acrobotic/IK_Breakout_ATxmega32E5/pcb/fab/BOM.xls

IK Dragonfly – BOM
Cisco Zabala (x1sc0@acrobotic.com) last updated: 05.09.2014
Manufacturer | Manuf. Part Number | Vendor | Vendor Part Number | Type | Designator | Qty | Description | Case | SMD, BGA, LCC, OR TH | Notes
Rohm | MCR03ERTJ220 | Digi-Key | RHM22CGCT-ND | Resistors | R1, R2 | 2 | RES 22 OHM 1/10W 5% 0603 SMD | 0603 | SMD
Stackpole Electronics Inc | RMCF0603JT10K0 | Digi-Key | RMCF0603JT10K0CT-ND |  | R3 | 1 | RES 10K OHM 1/10W 5% 0603 | 0603 | SMD
Stackpole Electronics Inc | RMCF0603JT10K0 | Digi-Key | RMCF0603JT10K0CT-ND |  | R4 | 1 | RES 300 OHM 1/10W 5% 0603 | 0603 | SMD
Stackpole Electronics Inc | RMCF0603JT1K00 | Digi-Key | RMCF0603JT1K00CT-ND |  | R5, R6 | 2 | RES 1K OHM 1/10W 5% 0603 | 0603 | SMD
Yageo | CC0603ZRY5V9BB104 | Digi-Key | 311-1343-1-ND | Capacitors | C1, C2, C5, C6, C7 | 5 | CAP CER 0.1UF 50V Y5V 0603 | 0603 | SMD
Kemet | T491A106K010AT7280 | Digi-Key | 399-8268-1-ND |  | C3 | 1 | CAP TANT 10UF 10V 10% 1206 | 1206 | SMD
Murata | GRM188F51A475ZE20D | Digi-Key | 490-3302-1-ND |  | C4, C8 | 2 | CAP CER 4.7UF 10V Y5V 0603 | 0603 | SMD
Samsung | CIB10P330NC | Digi-Key | 1276-6387-1-ND | Inductors | L1, L2 | 2 | FERRITE CHIP 33 OHM 1000MA | 0603 | SMD
OSRAM | LB Q39E-N1P1-35-1 | Digi-Key | 475-2815-1-ND | LEDs | ON | 1 | LED CHIPLED BLUE 470NM 0603 SMD | 0603 | SMD
OSRAM | LY Q976-P1S2-36 | Digi-Key | 475-2558-1-ND | IC | L | 1 | LED CHIPLED 587NM YLW 0603 SMD | 0603 | SMD
Atmel | ATXMEGA32E5-AU | Mouser | 556-ATXMEGA32E5-AU | ICs | IC1 | 1 | IC MCU 8BIT 32KB FLASH 32TQFP | 32TQFP | SMD
FTDI | FT230XS-R | Mouser | 895-FT230XS-R |  | IC2 | 1 | IC USB SERIAL BASIC UART | 16SSOP | SMD
Micrel | MIC5219-3.3YM5 | Mouser | 998-MIC5219-3.3YM5TR |  | U1 | 1 | IC REG LDO 3.3V 0.5A | SOT23-5 | SMD
STM | LM4040D20IDBZR | Mouser | 595-LM4040D20IDBZR |  | U2 | 1 | IC VREF SHUNT 2.048V | SOT23-3 | SMD
Bourns Inc. | MF-FSMF050X-2 | Mouser | 652-MFFSMF050X-2 | Fuses | FUSE | 1 | FUSE PTC RESET 500MA SMD 0603 | 0603 | SMD
 |  | Acrobotic |  | Buttons | RESET | 1 | Momentary Tactile Push Button | 3mm x 3.5mm | SMD
 |  | Acrobotic | CON-00009 | Connectors | JP1, JP2, JP3, JP4 | 1 | 0.1” Pitch, 40-Pin (Male) |  | TH | Easily cut to length. Left open for user
 |  | Acrobotic | CON-00010 |  | J1 | 1 | Break-away Pin Connector, 0.1" Pitch, 2x3-Pin (Male, TH, used for ISP) |  | TH
 |  | Acrobotic | CON-00014 |  | USB | 1 | USB Micro-B Connector (Through Hole) |  | TH
