acrobotic/IK_Breakout_ATxmega32E5/pcb/ik_dragonfly.pdf

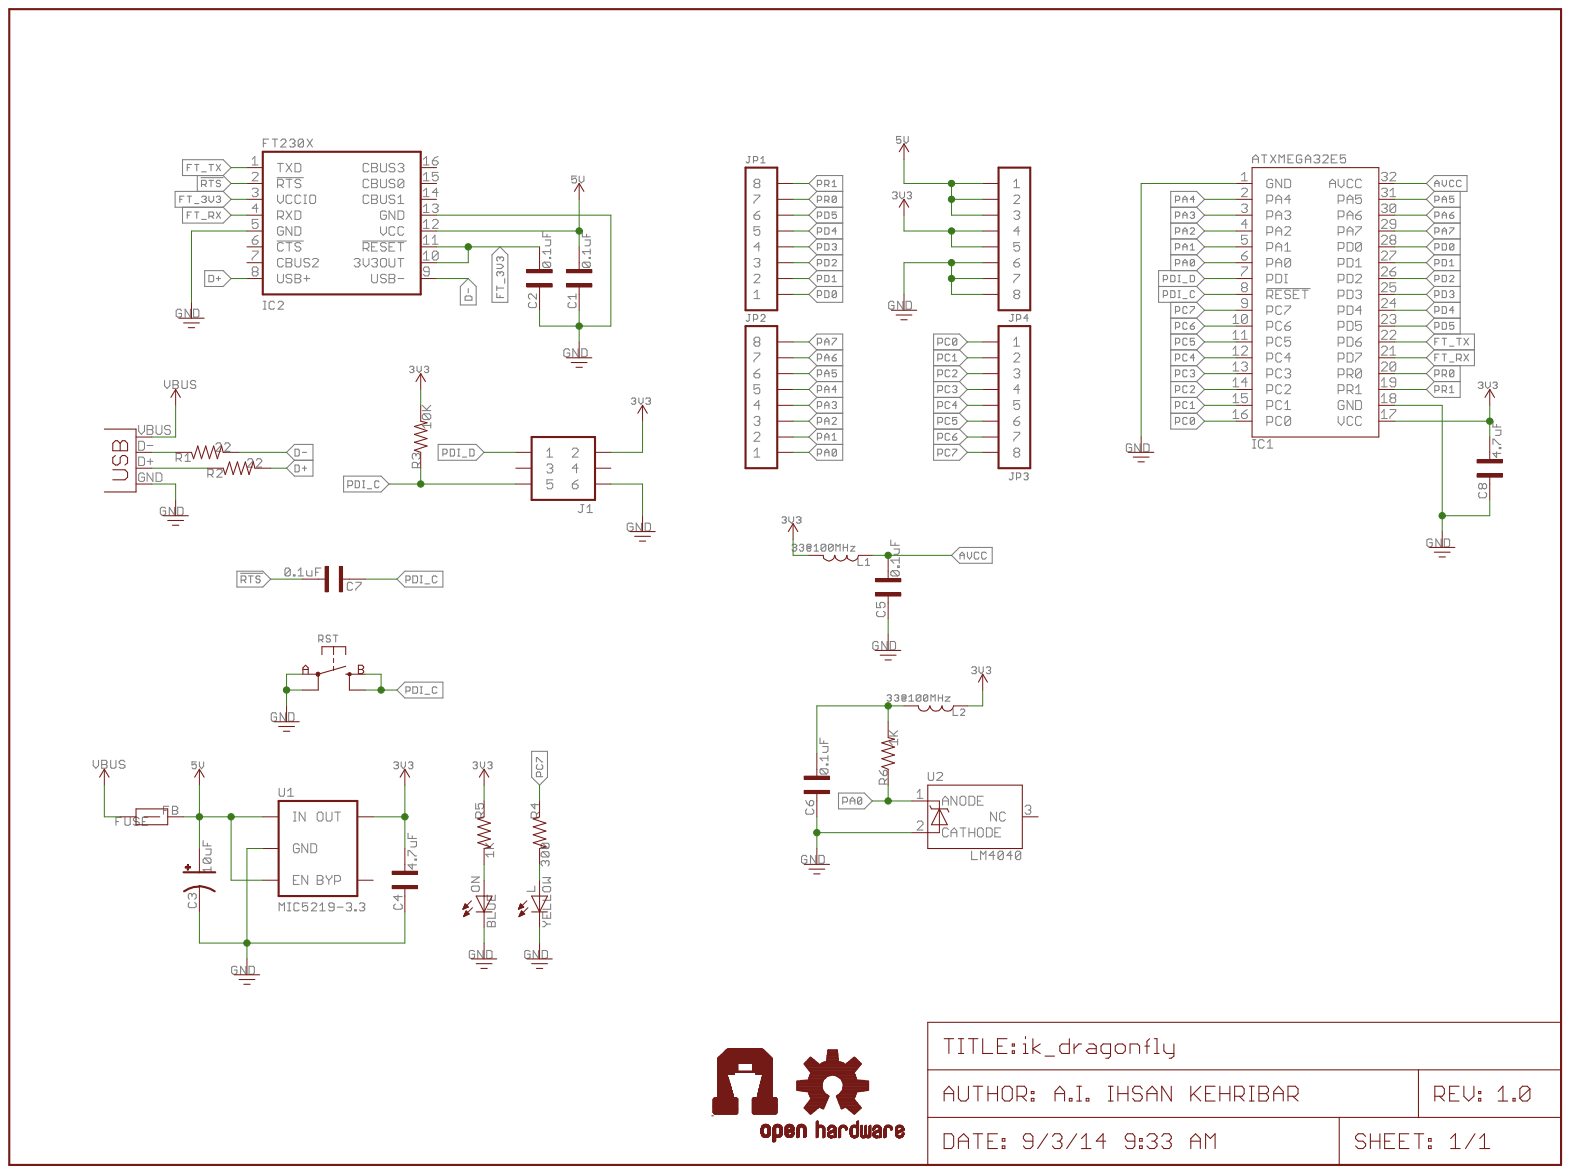
[picture p1: page 1]
