acrobotic/IK_Breakout_ATxmega32E5/pcb/ik_dragonfly.brd

## EAGLE design pcb/ik_dragonfly.brd (2014-08-26)

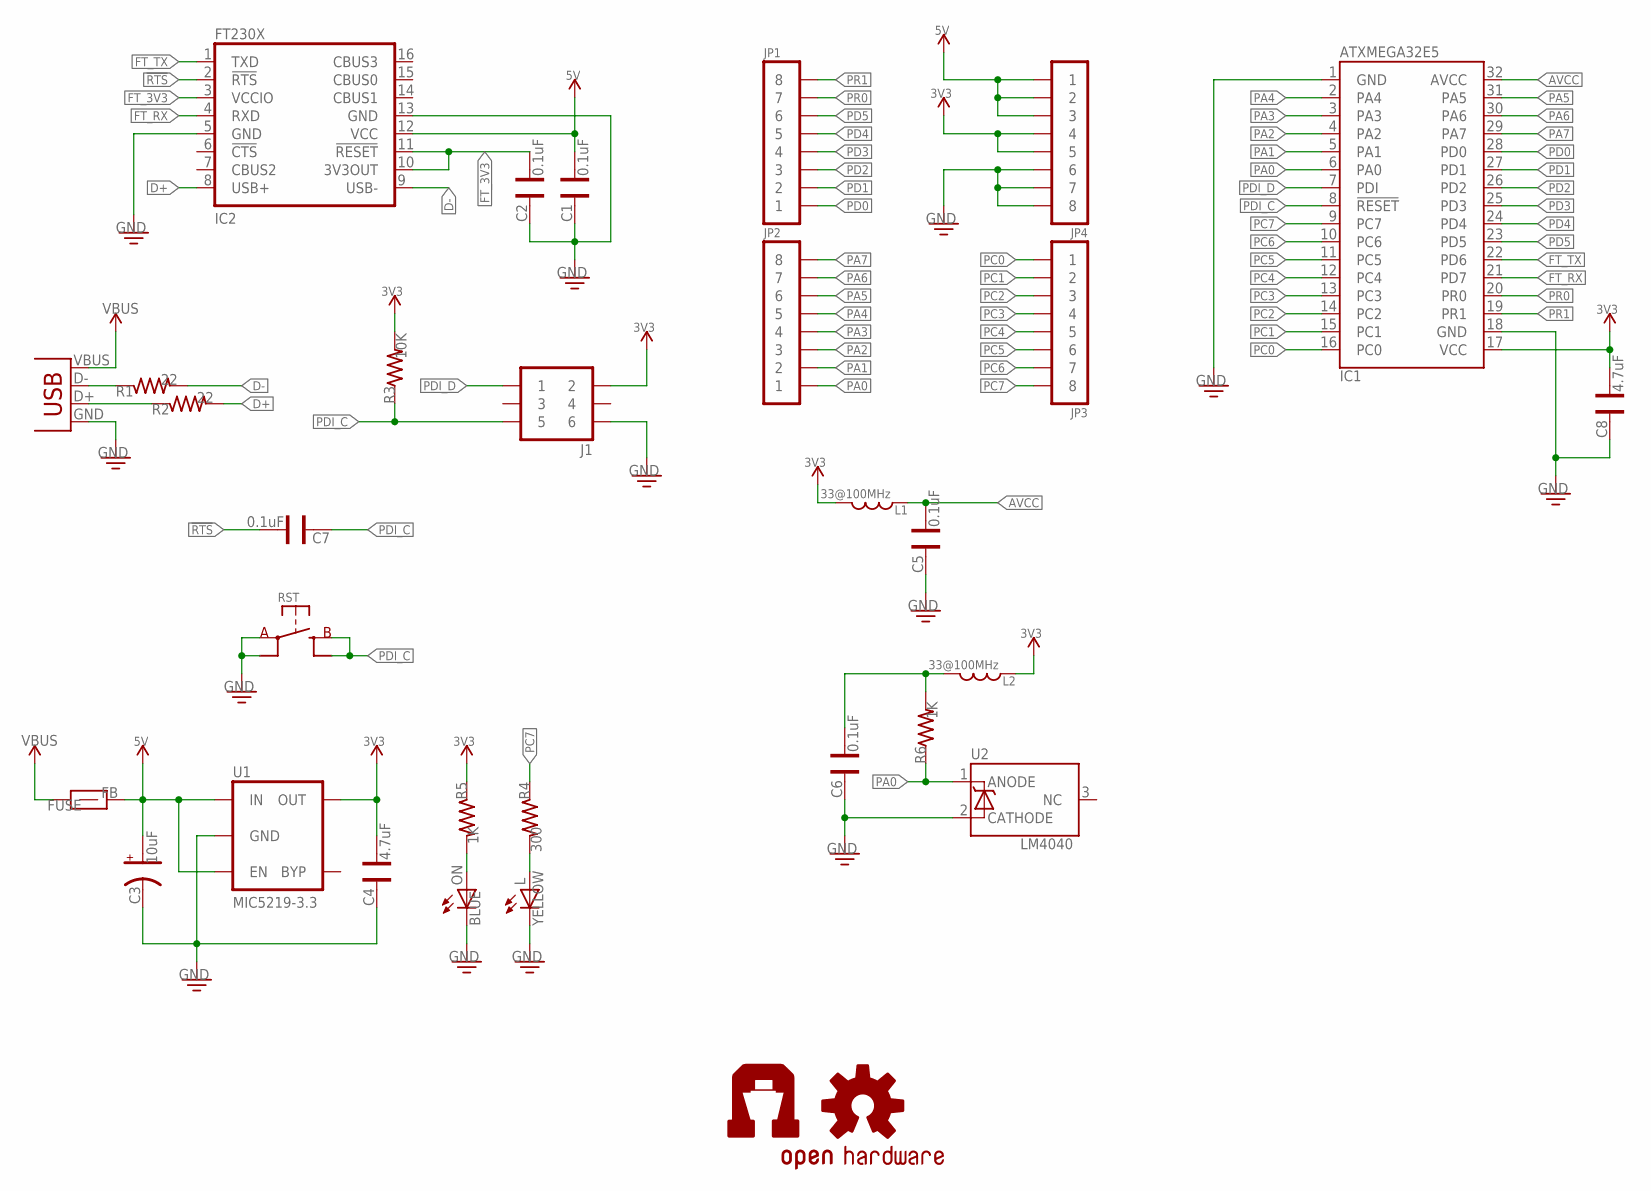
[picture p2: schematic ik_dragonfly.sch]

Parts:
C1, C2, C5, C6, C7: 0.1uF; CAP-0603
C3: 10uF; CAP-POL-EIA3216
C4, C8: 4.7uF; CAP-0603
FUSE: FB; FB-0603
IC1: ATXMEGA32E5; TQFP32-08
IC2: FT230X; SSOP-16-FTDI
J1: 2X03
JP1, JP2, JP3, JP4: 1X08NOFIRST; 1X08-NOFIRST
L: YELLOW; LED-0603
L1, L2: 33@100MHz; IND-0603
LOGO1: OSHW-LOGOS; OSHW-LOGO-S
ON: BLUE; LED-0603
R1, R2: 22; RES-0603
R3: 10K; RES-0603
R4: 300; RES-0603
R5, R6: 1K; RES-0603
RST: SW-SPSTSMD035X030; SW-SPST-SMD035X030
U1: MIC5219-3.3; SOT23-5
U2: LM4040; SOT23-3
U$3: AI-LOGOXS; AI-LOGO-XS
USB1: USBMICROB-TH; USB-MICROB-TH

Connections:
3V3: C4.1, C8.1, IC1.17 (VCC), J1.2, JP4.4, JP4.5, L1.1, L2.2, R3.2, R5.1, U1.5 (OUT)
5V: C1.1, C3.A, FUSE.2, IC2.12 (VCC), JP4.1, JP4.2, JP4.3, U1.1 (IN), U1.3 (EN)
!RTS: C7.1, IC2.2 (!RTS)
AVCC: C5.1, IC1.32 (AVCC), L1.2
D+: IC2.8 (USB+), R2.2
D-: IC2.9 (USB-), R1.2
FT_3V3: C2.1, IC2.3 (VCCIO), IC2.10 (3V3OUT), IC2.11 (!RESET)
FT_RX: IC1.21 (PD7), IC2.4 (RXD)
FT_TX: IC1.22 (PD6), IC2.1 (TXD)
GND: C1.2, C2.2, C3.C, C4.2, C5.2, C6.2, C8.2, IC1.1 (GND), IC1.18 (GND), IC2.5 (GND), IC2.13 (GND), J1.6, JP4.6, JP4.7, JP4.8, L.C, ON.C, RST.1 (A), RST.2 (A), U1.2 (GND), U2.2 (CATHODE), USB1.GND
unnamed: R1.1, USB1.D-
unnamed: R2.1, USB1.D+
unnamed: L.A, R4.2
unnamed: ON.A, R5.2
unnamed: C6.1, L2.1, R6.2
PA0: IC1.6 (PA0), JP2.1, R6.1, U2.1 (ANODE)
PA1: IC1.5 (PA1), JP2.2
PA2: IC1.4 (PA2), JP2.3
PA3: IC1.3 (PA3), JP2.4
PA4: IC1.2 (PA4), JP2.5
PA5: IC1.31 (PA5), JP2.6
PA6: IC1.30 (PA6), JP2.7
PA7: IC1.29 (PA7), JP2.8
PC0: IC1.16 (PC0), JP3.1
PC1: IC1.15 (PC1), JP3.2
PC2: IC1.14 (PC2), JP3.3
PC3: IC1.13 (PC3), JP3.4
PC4: IC1.12 (PC4), JP3.5
PC5: IC1.11 (PC5), JP3.6
PC6: IC1.10 (PC6), JP3.7
PC7: IC1.9 (PC7), JP3.8, R4.1
PD0: IC1.28 (PD0), JP1.1
PD1: IC1.27 (PD1), JP1.2
PD2: IC1.26 (PD2), JP1.3
PD3: IC1.25 (PD3), JP1.4
PD4: IC1.24 (PD4), JP1.5
PD5: IC1.23 (PD5), JP1.6
PDI_C: C7.2, IC1.8 (!RESET), J1.5, R3.1, RST.3 (B), RST.4 (B)
PDI_D: IC1.7 (PDI), J1.1
PR0: IC1.20 (PR0), JP1.7
PR1: IC1.19 (PR1), JP1.8
VBUS: FUSE.1, USB1.VBUS

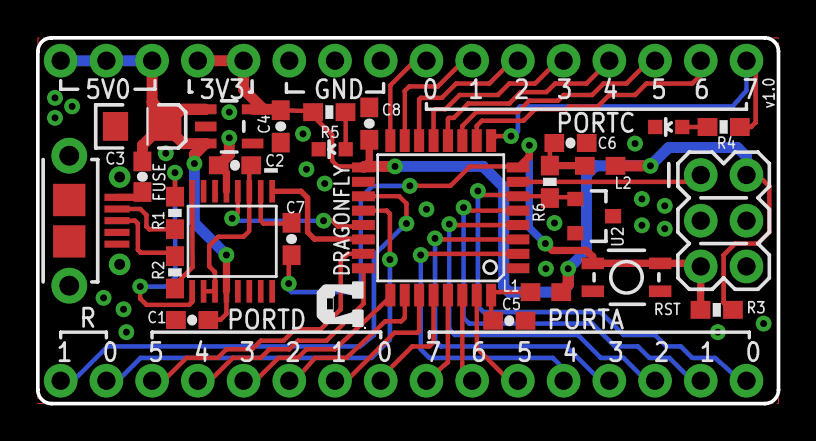
[picture p3: board ik_dragonfly.brd from above]

Board: 2 copper layers, 41.1 x 20.3 mm, 32 parts (1 on the bottom side), 42 nets.
