acrobotic/IK_Breakout_ATxmega32E5/pcb/ik_breakout_ atxmega32E5.brd

## EAGLE design pcb/ik_breakout_ atxmega32E5.brd (2014-08-21)

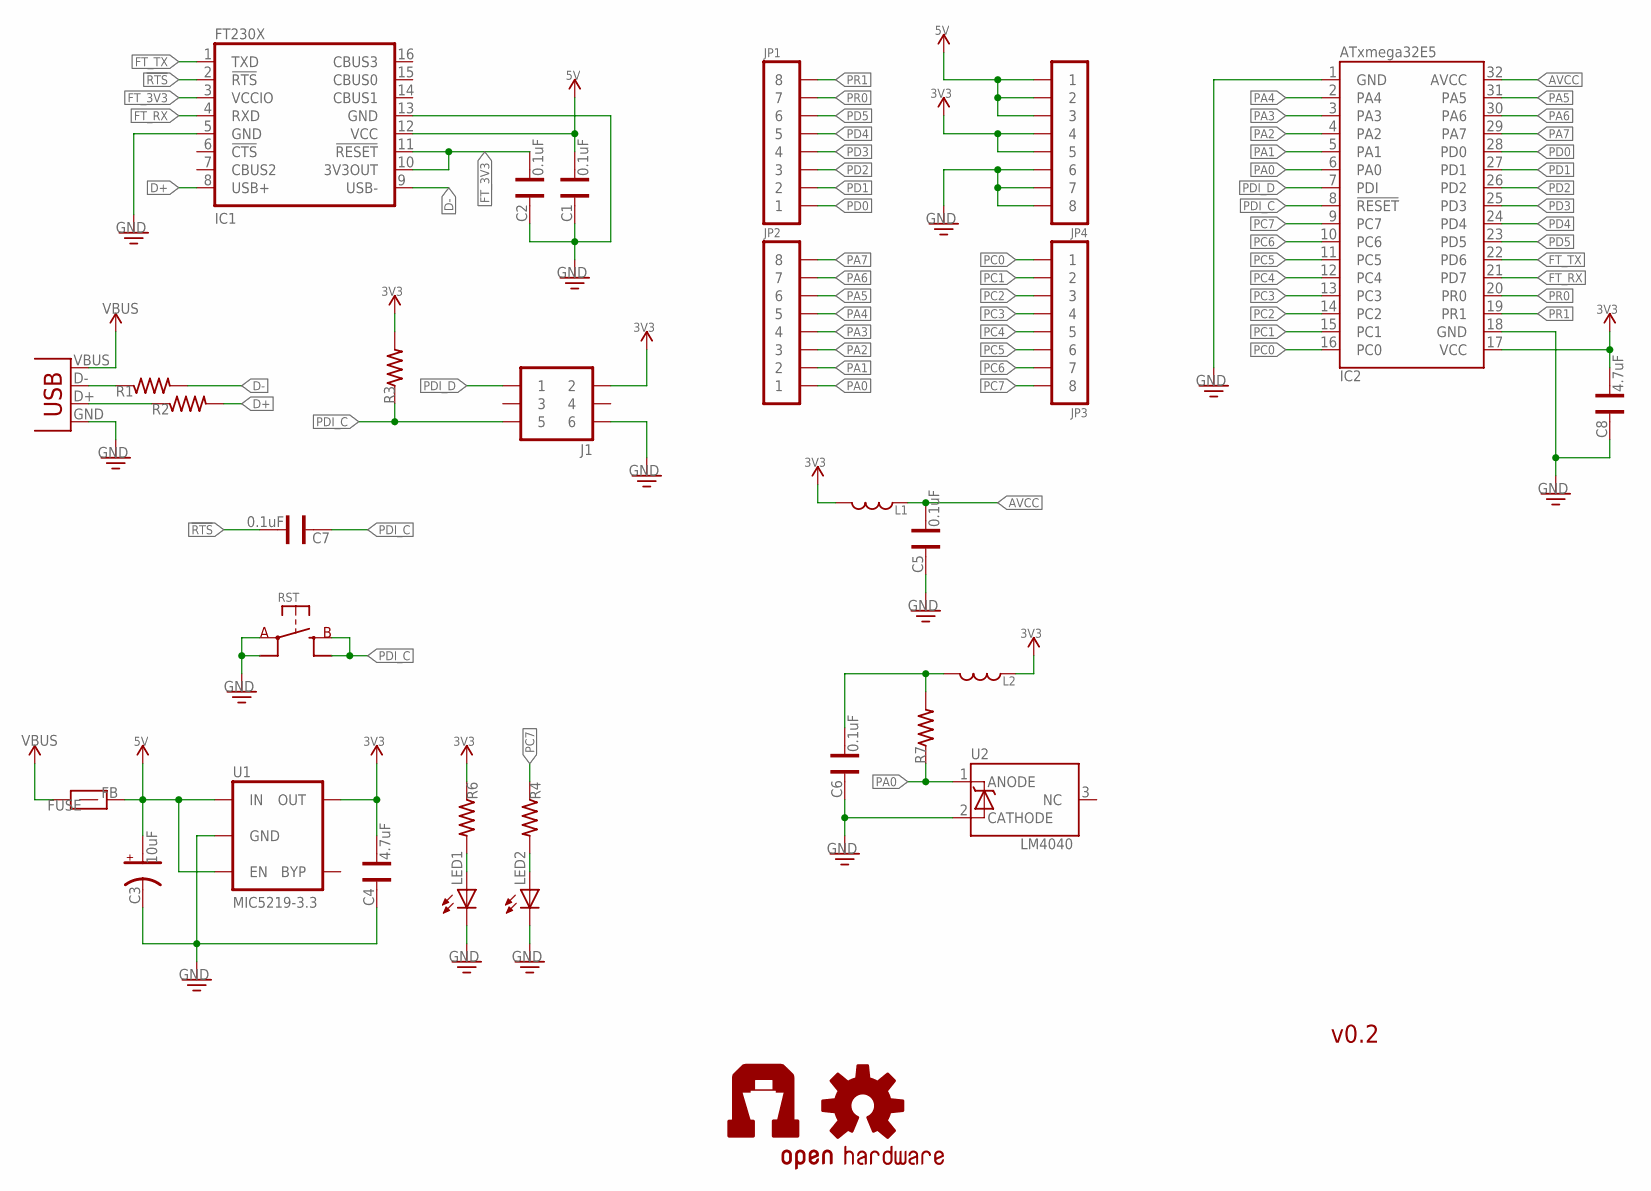
[picture p4: schematic ik_breakout_ atxmega32E5.sch]

Parts:
C1, C2, C5, C6, C7: 0.1uF; CAP-0603
C3: 10uF; CAP-POL-EIA3216
C4, C8: 4.7uF; CAP-0603
FUSE: FB; FB-0603
IC1: FT230X; SSOP-16-FTDI
IC2: ATXMEGA32E5; TQFP32-08
J1: 2X03
JP1, JP2, JP3, JP4: 1X08NOFIRST; 1X08-NOFIRST
L1, L2: IND0603; IND-0603
LED1, LED2: LED0603; LED-0603
LOGO1: OSHW-LOGOS; OSHW-LOGO-S
R1, R2, R3, R4, R6, R7: RES0603; RES-0603
RST: SW-SPSTSMD03X026; SW-SPST-SMD03X026
U1: MIC5219-3.3; SOT23-5
U2: LM4040; SOT23-3
U$3: AI-LOGOXS; AI-LOGO-XS
USB1: USBMICROB-TH; USB-MICROB-TH

Connections:
3V3: C4.1, C8.1, IC2.17 (VCC), J1.2, JP4.4, JP4.5, L1.1, L2.2, R3.2, R6.1, U1.5 (OUT)
5V: C1.1, C3.A, FUSE.2, IC1.12 (VCC), JP4.1, JP4.2, JP4.3, U1.1 (IN), U1.3 (EN)
!RTS: C7.1, IC1.2 (!RTS)
AVCC: C5.1, IC2.32 (AVCC), L1.2
D+: IC1.8 (USB+), R2.2
D-: IC1.9 (USB-), R1.2
FT_3V3: C2.1, IC1.3 (VCCIO), IC1.10 (3V3OUT), IC1.11 (!RESET)
FT_RX: IC1.4 (RXD), IC2.21 (PD7)
FT_TX: IC1.1 (TXD), IC2.22 (PD6)
GND: C1.2, C2.2, C3.C, C4.2, C5.2, C6.2, C8.2, IC1.5 (GND), IC1.13 (GND), IC2.1 (GND), IC2.18 (GND), J1.6, JP4.6, JP4.7, JP4.8, LED1.C, LED2.C, RST.1 (A), RST.2 (A), U1.2 (GND), U2.2 (CATHODE), USB1.GND
unnamed: R1.1, USB1.D-
unnamed: R2.1, USB1.D+
unnamed: LED2.A, R4.2
unnamed: LED1.A, R6.2
unnamed: C6.1, L2.1, R7.2
PA0: IC2.6 (PA0), JP2.1, R7.1, U2.1 (ANODE)
PA1: IC2.5 (PA1), JP2.2
PA2: IC2.4 (PA2), JP2.3
PA3: IC2.3 (PA3), JP2.4
PA4: IC2.2 (PA4), JP2.5
PA5: IC2.31 (PA5), JP2.6
PA6: IC2.30 (PA6), JP2.7
PA7: IC2.29 (PA7), JP2.8
PC0: IC2.16 (PC0), JP3.1
PC1: IC2.15 (PC1), JP3.2
PC2: IC2.14 (PC2), JP3.3
PC3: IC2.13 (PC3), JP3.4
PC4: IC2.12 (PC4), JP3.5
PC5: IC2.11 (PC5), JP3.6
PC6: IC2.10 (PC6), JP3.7
PC7: IC2.9 (PC7), JP3.8, R4.1
PD0: IC2.28 (PD0), JP1.1
PD1: IC2.27 (PD1), JP1.2
PD2: IC2.26 (PD2), JP1.3
PD3: IC2.25 (PD3), JP1.4
PD4: IC2.24 (PD4), JP1.5
PD5: IC2.23 (PD5), JP1.6
PDI_C: C7.2, IC2.8 (!RESET), J1.5, R3.1, RST.3 (B), RST.4 (B)
PDI_D: IC2.7 (PDI), J1.1
PR0: IC2.20 (PR0), JP1.7
PR1: IC2.19 (PR1), JP1.8
VBUS: FUSE.1, USB1.VBUS

Notes on the sheet:
v0.2

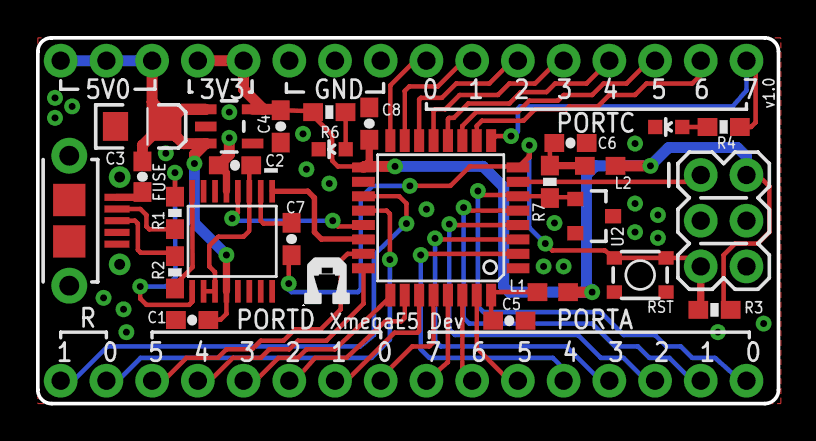
[picture p5: board ik_breakout_ atxmega32E5.brd from above]

Board: 2 copper layers, 41.1 x 20.3 mm, 32 parts (1 on the bottom side), 42 nets.
