acrobotic/IK_Breakout_ATxmega32E5/(commit log)

2014-08-21 revised version
    [ik_breakout_ atxmega32E5.gbl, ik_breakout_ atxmega32E5.gbo, ik_breakout_ atxmega32E5.gbs, ik_breakout_ atxmega32E5.gtl, ik_breakout_ atxmega32E5.gto, ik_breakout_ atxmega32E5.gtp, ik_breakout_ atxmega32E5.gts]
2014-08-21 oops. committed from /pcb/fab/gerbers folder.
    [ik_breakout_ atxmega32E5.brd, ik_breakout_ atxmega32E5.sch]
2014-08-21 changed LM4040 to include part on Ai_Power library
    [ik_breakout_ atxmega32E5.brd, ik_breakout_ atxmega32E5.sch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]
2014-08-22 updated BOM
    [BOM.xls, ik_dragonfly.brd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]
2014-08-23 finished BOM
    [BOM.xls, ik_dragonfly.brd, ik_dragonfly.sch]
2014-08-23 finished (for reals) BOM
    [BOM.xls, ik_dragonfly.brd, ik_dragonfly.sch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]
2014-08-26 minor revision
    [ik_dragonfly.brd, ik_dragonfly.sch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]
2014-09-05 styling BOM
    [BOM.xls]
2014-09-05 better pricing options on BOM
    [BOM.xls]
